Kruemelbahn/LocoNet-FastClock-Slave/README.md

# LocoNet-FastClock-Slave

LocoNet-FastClock is a slave-clock, which is connected to the LocoNET on modelrailroad-layouts.<br>
The slave-clock supports several control modes, e.g. direct control or FastClock.<br>
For more details please refer to the [manual](Documentation/LocoNET-FastClock.pdf)<br>

### Requested libraries
LocoNet-FastClock requires my library listed below in addition to various Arduino standard libraries:<br> 
- [4x7Segment](https://www.github.com/Kruemelbahn/4x7Segment)
- [HeartBeat](https://www.github.com/Kruemelbahn/HeartBeat)
- [LCDPanel](https://www.github.com/Kruemelbahn/LCDPanel)
